yingzhang536/esp32-remote-power/(commit log)

2026-11-03 ESP32 远程开机控制器：固件+服务端+模拟器（真实主板验证通过）
2026-11-03 新增 README（架构图+部署+验证记录），移除需求文档（内容并入 README）
2026-11-03 新增架构图（graphviz PNG，深色主题分层）并替换 README 中的 mermaid
2026-11-03 架构图移到仓库根目录（README 同层）
2026-11-03 README 修正：部署命令补 server/ 路径、端口约定说明（1883 内网/8081 公网）、过时引用清理
